djbouns/aquaboun-s/AQUABOUNS_MEGA_v1.2/autres.h

#ifndef  _autres_h_
#define _autres_h_

//$$$$$$$$$$$$$$$$$$$$$$$$$$$$$$$$$$$$$$$$$$$$$$$$$$$$$$$$$$$$$$$$$$$$$$$$$$$$$$$$$$$$$$$$$$$ Librairies $$$$$$$$$$$$$$$$$$$$$$$$$$$$$$$$$$$$$$$$$$$$$$$$$$$$$$$$$$$$$$$$$$$$$$$$$$$$$$$$$$$$$$$$$$$
#include <arduino.h>

//$$$$$$$$$$$$$$$$$$$$$$$$$$$$$$$$$$$$$$$$$$$$$$$$$$$$$$$$$$$$$$$$$$$$$$$$$$$$$$$$$$$$$$$$$$$ Declarations des fonctions dans le .cpp $$$$$$$$$$$$$$$$$$$$$$$$$$$$$$$$$$$$$$$$$$$$$$$$$$$$$$$$$$$$$$$
void nourrissage();
void graphique();
void etablirValeursParDefaut();
void rebootAlarme();
void coupureEdf();
void alarme();
void reboot(const uint8_t pinHardReset);
void coupureBatterie();

#endif
