djbouns/aquaboun-s/AQUABOUNS_MEGA_v1.2/brassage.h

#ifndef  _brassage_h_
#define _brassage_h_

//$$$$$$$$$$$$$$$$$$$$$$$$$$$$$$$$$$$$$$$$$$$$$$$$$$$$$$$$$$$$$$$$$$$$$$$$$$$$$$$$$$$$$$$$$$$ Declarations des fonctions dans le .cpp $$$$$$$$$$$$$$$$$$$$$$$$$$$$$$$$$$$$$$$$$$$$$$$$$$$$$$$$$$$$$$$
void brassage();
void definiTempeteAleatoire();
void tempeteAleatoireAutomatique();

#endif
